hughjazzman/mBot/(commit log)

2019-10-29 Added LDR Sensor using RGB. Added definitions, comments.
2019-11-01 Added separate file for colour calibration. More comments.
2019-11-05 Implemented IR calibrator
2019-11-05 Calibrated colours. More comments
2019-11-07 Changed colour calibration, uses only 1 colour (cyan) to determine all colours. Edited values relating to movement.
2019-11-07 Changed colour calibration, uses only 1 colour (cyan) to determine all colours. Give blue bigger threshold.
2019-11-08 Fixed colour cal, moved music notes.
    [Notes.h]
2019-11-08 Fixed code 8 Nov. Colour calibrated. Comments. Header file for constants and objects.
    [Notes.h, colourcal.ino, main.ino]
2019-11-11 Added instructions for colour calibration.
2019-11-12 Implemented ultrasonic front-facing sensor
2019-11-12 Implemented ultrasonic "side" sensor, in case IR is still unreliable
2019-11-12 Fixed Color calibration
2019-11-12 Movement adjustment (ultrasonic).
2019-11-13 Implemented ultrasonic in normal movement and made some calibrations
